dsheffie/hw-rasterizer/(commit log)

2023-11-26 broken control flow but rasterizing x dim
2023-11-27 maybe flow control works
2026-06-07 fix early termination in triangle and build on linux
    [rasterize.sv, top.cc]
2026-06-08 refactor host triangle setup into setup.cc; software depth buffer
    Split the host-side geometry math out of the RTL harness:
    - setup.{h,cc}: vertex3d, tri_setup, and setup_triangle() compute the
    edge weights and depth plane equation (dzdx/dzdy/z_start, area) that
    the rasterizer RTL iterates. No Verilator dependency.
    - top.cc: now strictly RTL interaction -- model, framebuffer, software
    depth buffer (nearest-z test), and PPM output. render_triangle() draws
    two intersecting-plane triangles to exercise the depth test. Dropped
    dead debug code (crossp/check_frag/pixel_t/w_int/n_pix).
    - Makefile: build setup.o.
    - .gitignore: ignore build artifacts.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
2026-06-08 interpolate depth in fixed-point, normalized once per triangle
    Replace the unnormalized z*area depth path with a true fixed-point
    representation, dividing by area once per triangle in setup instead of
    once per fragment in the harness.
    - rasterize.sv: depth stepper widened to a named DEPTH_INT_BITS.DEPTH_
    FRAC_BITS (25.12) format; output drops the fraction bits.
    - setup.{h,cc}: normalize dz/dx, dz/dy and Zs by 2*area into Q.12 fixed
    point (with +0.5 LSB rounding); drop the now-unused 'area' field.
    - top.cc: pixel_q is already true depth, so remove the per-fragment
    divide before the depth test.
    Bounded register width (independent of triangle/screen size) and depths
    that are directly co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
    [rasterize.sv, setup.cc, setup.h, top.cc]
2026-06-08 docs: add HTML writeup of the depth setup + stepping flow
    Document the host/hardware split: setup.cc computes edge functions and
    the depth plane (Cramer's rule, normalized once per triangle into the
    named DEPTH_*_BITS fixed-point format), and rasterize.sv steps it. Covers
    the format constants, the stepper, the end-to-end data flow, and the
    bounded-width vs rounding trade-off.
2026-06-08 flatten triangle_t struct into individual vertex registers
    r_tri only ever held the six latched input coords; replace the packed
    struct with plain logic [31:0] registers (r_v0_x .. r_v2_y) to match the
    rest of the module's style. Pure rename, no behavior change.
    [rasterize.sv]
2026-06-08 add 3D software pipeline to render OBJ models
    The rasterizer RTL only does 2D screen-space rasterization (per the CRIME
    model, the host does everything before rasterization). Add the host-side
    front-end that turns a model into the screen-space triangles setup.cc
    already consumes:
    - obj.{h,cc}: minimal Wavefront OBJ loader (v/f, fan-triangulates polys).
    - pipeline.{h,cc}: model/view/projection transform, near-plane reject,
    perspective divide, viewport mapping, screen-winding fixup (so coverage
    matches the RTL), and flat (N.L) shading. Auto-fits the model to the view.
    - top.cc: load the model (path from argv, default bigguy.obj), run the
    pipeline, rasterize each triangle; add a framebuf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
    [obj.cc, obj.h, pipeline.cc, pipeline.h, top.cc]
2026-06-08 docs: expand HTML writeup to the full OBJ-to-pixels pipeline
    Broaden the depth-focused doc into an end-to-end architecture overview:
    add the model loader (obj.cc) and the 3D software pipeline (pipeline.cc --
    transform, project, near-reject, winding fixup, flat shading), with a file
    map and a stage diagram. Keep the per-triangle setup, fixed-point format,
    RTL stepper, and software depth-buffer sections, reframed as stages of the
    larger pipeline.
2026-06-08 docs: add next-steps roadmap
    Capture the deferred first-cut items (near-plane clipping, screen-edge
    clipping, backface culling), the CRIME-style trajectory of moving the
    depth buffer into hardware, rendering features (smooth shading,
    perspective-correct attributes, textures), and repo hygiene (OBJ test
    assets, a deterministic depth regression).
2026-06-08 add backface culling (toggle with --no-cull)
    Cull triangles whose eye-space normal points away from the camera before
    rasterizing. For a closed mesh this drops ~half the triangles with no
    visible change (the depth buffer was hiding them anyway).
    Measured on bigguy.obj: 2872 -> 1437 triangles, 405k -> 207k clocks,
    116k -> 58k fragments; the lit image is identical except ~0.7% of pixels
    along silhouette/fold edges, where removing back faces flips a few
    integer-depth ties.
    On by default; --no-cull disables it for A/B comparison.
    [pipeline.cc, pipeline.h, top.cc]
2026-06-09 docs: add tile-based architecture target and CRIME UMA tradeoff
    Capture the on-chip-tile (render-to-SRAM) target that closes the framebuffer
    bandwidth wall, and contrast it with CRIME's shared-UMA bet (media interop,
    flexibility, cost vs 3D throughput). Notes the tile/TLB naming collision.
2026-06-18 add perspective-correct texture mapping (host UV + RTL steppers)
    Parse vt texcoords and carry uv + 1/w through the pipeline, set up u/w,
    t/w, 1/w as screen-space planes (same Cramer's-rule determinant as the
    depth plane), and interpolate them in the RTL with three steppers that
    mirror the existing depth stepper. top.cc feeds the host-computed plane
    gradients as fixed point, reads the stepped values back from the fragment
    queue, does the per-fragment reciprocal, recovers (u,v), and samples a
    procedural checkerboard modulated by the flat shade.
    - obj.cc/obj.h: parse and store vt per face vertex
    - pipeline.cc/pipeline.h: screen_tri carries uv + 1/w (follows winding swap)
    - setup.cc/setup.h: se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
    [obj.cc, obj.h, pipeline.cc, pipeline.h, rasterize.sv, setup.cc, setup.h, top.cc]
2026-06-18 prototype the fixed-point reciprocal in software (Stage C groundwork)
    Replace the float 1/w divide with recip_fixed(): a bit-accurate software
    model of the planned RTL reciprocal unit -- normalize via clz, 256-entry
    Q16 seed ROM, Newton y' = y*(2 - d*y). Every internal op is integer and
    maps 1:1 to hardware (clz, shift, table lookup, 2 mults/iter).
    Instrument worst-case relative error over the real 1/w values rendered:
    seed-only 0.20%, +1 Newton 0.003%, +2 Newton 0.0029% (Q16 floor).
    Confirms an 8-bit seed + 1 Newton iteration is the sweet spot.
    Image is pixel-identical to the float divide; no RTL yet, the module is
    now a mechanical transcription of this model.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
    [top.cc]
2026-06-18 add --spin N to render a rotation sequence for artifact inspection
    Parameterize project_mesh with a yaw angle (default 35 deg, so single-frame
    behavior is unchanged) and add --spin N to top.cc, which renders N frames
    over 360 deg as frame_NNN.ppm. Used to eyeball perspective-correctness and
    texture artifacts in motion (ffmpeg/convert the frames into mp4/gif).
    Also gitignore the render outputs (frame_*.ppm, *.mp4, *.gif).
    [pipeline.cc, pipeline.h, top.cc]
2026-06-18 add --sdl live viewer (spin the model in a window)
    Renders each frame through the RTL into a streaming RGB24 SDL texture, so
    texture/perspective artifacts can be inspected interactively in motion.
    Controls: Esc/Q quit, Space pause, Left/Right nudge yaw. Degrades to a
    clean error if no display is available.
    Linux now links SDL2 via pkg-config (cflags + libs), matching the Darwin
    branch that already linked it.
    [top.cc]
2026-06-18 integrate the hardware reciprocal into the rasterizer datapath
    The 1/w stepper now feeds the pipelined recip; a 4-deep side-band carries
    (addr, depth, u/w, t/w) in lockstep with the reciprocal's latency so they
    realign at the output, where a multiply + variable shift recovers u,v in
    Q16 (u = (sw*y) >> e). The output queue now carries (addr, depth, u, v);
    push fires on recip.valid_out, and DRAIN waits for the recip pipe to flush
    (busy) as well as the queue. A global clock-enable (= queue-not-full)
    freezes scan + recip + side-band together so a full queue never drops
    in-flight fragments.
    recip.sv gains en (clock-enable) and busy; still bit-exact in recip_tb.
    top.cc reads u_q/v_q directly an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
2026-06-18 move depth buffer into BRAM (HW depth test) + pipeline the attribute multiplies
    The two changes are intertwined in rasterize.sv (the multiply pipeline feeds
    the depth-test stage), so they land together.
    Hardware depth buffer:
    - Z BRAM (16-bit x SCREEN_W*SCREEN_H) with a 1-stage depth test (Z1) that
    absorbs the BRAM read latency: register the fragment + its depth read, then
    compare (nearest wins) and on pass write depth + push (addr,u,v). Only
    depth-passing fragments enter the queue, so depth drops out of the
    interface (pixel_q removed).
    - clear FSM: a `clear` pulse walks the buffer writing the far value; `clearing`
    high meanwhile. top.cc drops its software z-buffer and clears th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
2026-06-18 move color framebuffer + texturing/shading into BRAM (on-chip backend)
    The whole fragment backend now lives in the PL. At the depth-test stage,
    depth-passing fragments are shaded and written straight into an on-chip color
    framebuffer; the host just feeds triangles and scans the framebuffer out.
    rasterize.sv:
    - color FB BRAM (24-bit) + host readout port (fb_raddr/fb_rdata, registered).
    - checkerboard texture-gen in RTL: tile parity = u_q16[13]^v_q16[13] (8 tiles).
    - shade modulate in RTL: floor(texel*shade/255) exact via ((x+1)*257)>>16.
    - color written alongside the depth write; the clear FSM now clears both
    color and depth in one sweep.
    - output queue removed entirely (the FB write is t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
2026-06-18 add Gouraud shading (per-vertex lighting, affine color steppers)
    Parse vn for per-vertex normals; light each vertex by its own eye-space
    normal (two-sided N.L, falls back to the face normal if a vertex has none)
    and carry per-vertex RGB through to the rasterizer. Three affine color
    steppers (no reciprocal -- color interpolates linearly in screen space, the
    classic GL/Quake behavior) interpolate R,G,B; the per-pixel color is clamped
    to [0,255] and carried down the side-band -> MUL -> SHIFT -> Z1 alongside the
    fragment, then modulates the checkerboard texel (GL_MODULATE) in place of the
    old flat per-triangle shade.
    - obj.cc/obj.h: parse and store per-vertex normals
    - pipeline.cc/pipeline.h: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
2026-06-18 add real texture memory (sampled texture BRAM, REPEAT wrap)
    Replace the procedural checkerboard with a sampled texture in BRAM.
    - texture BRAM (128x128 24-bit RGB), power-of-two so REPEAT wrap is just a
    low-bit mask (handles negative/tiling uv via arithmetic shift + mask).
    - texel address = uv >> (16-TEX_LW), low TEX_LW bits per axis.
    - texture read issued at the Z1 input (SHIFT-stage uv) so the texel lands at
    Z1 aligned with the fragment -- same trick as the depth read, no new stage.
    - host write port (tex_we/tex_waddr/tex_wdata) to load the texture.
    - modulate is now texel * Gouraud color per channel (full GL_MODULATE).
    top.cc: load_test_texture uploads a u->red,v->gree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
    [rasterize.sv, top.cc]
2026-06-19 add bilinear texture filtering (4-bank quad fetch) + build-time resolution knob
    Bilinear filtering:
    - split the texture into 4 BRAM banks by (x&1,y&1) so any 2x2 quad is one
    texel per bank -> all four read in parallel, conflict-free, in one cycle
    (no added latency; reads issued at the Z1 input like the depth read).
    - texel coord with a half-texel offset -> base texel + Q9 fractions + parities;
    REPEAT via low-bit mask (power-of-two, so no out-of-bounds possible).
    - per-bank address gen picks each bank's column/row by parity; host loads
    linearly and the RTL routes each texel to bank {tv[0],tu[0]} at (tv>>1,tu>>1).
    - un-swizzle crossbar maps the 4 banks to T00/T10/T01/T11 by (px,py), th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
    [rasterize.sv, top.cc]
2026-06-19 add mipmapping (per-triangle LOD, bilinear on the selected level)
    Fixes the minification "popping"/shimmer: instead of undersampling the full
    resolution texture on far/oblique surfaces, sample a pre-averaged mip level.
    top.cc:
    - build the mip chain by box-filter downsampling (8 levels, 128..1).
    - per-triangle LOD = 0.5*log2(texel_area / screen_area), clamped [0,7] -- the
    area-ratio form of the uv Jacobian, computed on the A53.
    - upload to the banked stacked storage (texel -> bank {y&1,x&1}, addr
    {level, y>>1, x>>1}).
    - the 4 bilinear banks now hold the whole mip chain, a uniform (TEX_W/2)^2 slot
    per level, so a bank address is just {level, row>>1, col>>1} (no var stride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
    [rasterize.sv, top.cc]
2026-06-19 docs: add datapath block diagram
    Curated Graphviz block diagram of rasterize.sv + recip.sv (host setup vs PL
    iteration, the stepper/recip/texture/depth stages, on-chip memories, and the
    side-band), embedded on the home and hardware-pipeline pages. The .dot source
    lives alongside so it can track the RTL (regenerate with dot -Tsvg).
2026-06-19 add per-pixel level of detail (analytic uv Jacobian)
    Replaces the per-triangle LOD, which made the mip level constant across each
    face -- on large faces at varying grazing angles (e.g. a torus) adjacent faces
    picked different levels and the texture detail shattered at every seam.
    Per fragment, compute the uv Jacobian analytically (no neighbor sampling):
    du/dx = w*(d(u/w)/dx - u*d(1/w)/dx), etc.
    using the constant per-triangle gradients (dswdx, diwdx, ...) and the per-pixel
    u, v, and w. w is carried down as w*16 = y>>e (free from the reciprocal's
    mantissa/exponent). Take max|.| of the four partials, multiply by w, and clz
    the footprint: LOD = msb + TEX_LW - 16, clamped [0,7]. This per-p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
    [rasterize.sv, top.cc]
2026-06-19 use a broadband (value-noise) default texture; --grid keeps the debug grid
    The UV gradient+grid texture is a worst case for aliasing (1-texel high-contrast
    lines zig-zag under per-pixel sampling). Default to a broadband tiling
    value-noise "stone" texture (2 smoothstep octaves, seamless at the edge), which
    mipmaps and filters cleanly -- the texture-line jaggies are gone, leaving only
    the geometry silhouette (which needs real AA). --grid restores the gradient+grid
    for UV/perspective debugging.
    [top.cc]
2026-06-19 rtl: drop +: part-selects; add alpha blending
    - replace the variable-base +: part-selects (per-pixel mip fraction) with an
    explicit shift + fixed range, per the Verilog conventions. Verified no-op.
    - alpha blending: per-triangle blend_mode (0 opaque / 1 src-over / 2 additive)
    + tri_alpha. The color framebuffer becomes a read-modify-write (dst read
    issued at the Z1 input like the depth read, blended via blend_c, written
    back). Non-opaque modes test depth but suppress the depth write (standard
    transparency). blend_c reuses the exact /255 for src-over.
    [rasterize.sv]
2026-06-19 add hw_rast engine abstraction (Verilated backend); --blend demo
    Introduce hw_rast.h: an abstraction over the rasterizer engine so the graphics
    stack is built on a stable API, not the transport. hw_tri is one fully-set-up
    triangle (fields mirror the RTL ports); the opaque hw_rast handle exposes
    open/close/clear/tex_write/draw_tri/fb_read.
    hw_rast_verilated.cc implements it by driving the Vrasterize model (the tick/
    poke/readout logic moved out of top.cc). A future hw_rast_fpga.c implements
    the same header over AXI; switching backends is a link-time choice.
    top.cc now does only the per-triangle setup math (CPU, shared by all backends),
    fills an hw_tri, and calls hw_draw_tri -- no Verilato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
2026-06-19 split top.cc: extract reusable engine front-end (gfx) from the OBJ demo
    Pull the host-side glue that any engine driver needs out of top.cc into gfx.cc
    (on top of hw_rast.h), so it can be shared with the coming IRIS GL / libgl
    backend instead of being duplicated:
    - submit_triangle(): the per-triangle setup math (edge functions, depth/
    attribute/color planes) -> hw_tri -> hw_draw_tri.
    - load_texture(): build the mip chain from a base image + banked upload.
    Plain-C interface (no pipeline.h/setup.h leakage) so a C backend can call it.
    top.cc -> obj_demo.cc, now purely the OBJ viewer (texture content generation,
    projection, frame loop, PPM, SDL, args); render_triangle is a thin screen_tri
    -> s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
    [gfx.cc, gfx.h, obj_demo.cc]
2026-06-19 add IRIS GL rasterizer backend + isolation test
    Implement sgi-demos libgl's rasterizer.h (hw_rasterizer.cc) by driving our
    hardware engine via gfx/hw_rast -- a drop-in for reference_rasterizer.c, so
    gl.c can rasterize SGI/IRIS GL demos on the (Verilated) PL. Maps screen
    vertices to the engine (/32 subpixel, GL y-up -> top-down, z>>16 to 16-bit,
    winding fix for our positive-area coverage), expands lines/points to quads, and
    scans the FB out to a BGRA front buffer. Untextured via a bound white texture
    (texel*color modulate passes Gouraud color through). First cut stubs: clear
    color (always black), zbuffer-disable, text glyphs, stipple.
    rasterize.sv: SCREEN_WIDTH/SCREEN_HEIGHT knobs (defaul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
    [hw_rasterizer.cc, rast_test.cc, rasterize.sv]
2026-06-19 run the SGI "ideas" IRIS GL demo on our engine
    Add a `make ideas` / `ideas_hw` target that builds the sgi-demos "ideas" demo
    the repo's own way (its shim / K&R-C / GLES handling, via clang) and re-links it
    against OUR rasterizer: by placing hw_rasterizer + the engine objects ahead of
    libgl.a, the linker resolves rasterizer_* from us and never pulls
    reference_rasterizer.o -- so we reuse gl.c/libdemo unmodified. Builds the engine
    at the SGI 800x480 display size. The demo renders recognizably end to end (lit
    floor, spotlight, card, SGI logo, the animated orb matches the reference).
    hw_rasterizer.cc: headless capture/exit hooks for verifying demos without a
    display -- GEN_FRAME_PPM_FILES=1 du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
    [hw_rasterizer.cc, setup.cc]
2026-06-19 docs: add Sub-pixel coordinates page
    New page explaining sub-pixel rasterization: the integer-snapping problem
    (coarse staircase + crawl under motion), keeping the 1/32 fixed-point fraction,
    evaluating coverage at pixel centers in full precision, why the forward-
    differenced inner loop is unchanged (richer setup values only), the watertight-
    shared-edge and depth/attribute-accuracy payoffs, and that it's not antialiasing.
    Includes a Status section: our engine currently truncates to integer vertices
    (hw_rasterizer.cc sv.x/32), the source of the ragged edges in the IRIS GL demos,
    with the concrete fix.
    Insert it after Edge functions (nav_order 3); bump the following pages to 4..10,
    update the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
2026-06-19 implement sub-pixel coordinates across the engine
    Carry the 1/32 sub-pixel vertex fraction through coverage and plane setup instead
    of truncating to integer pixels, so triangle edges land where the geometry
    actually is (smoother silhouettes, no whole-pixel snapping/crawl) and adjacent
    edges stay watertight.
    - setup.cc: edge functions evaluated at each pixel's CENTER in ×32^2 units; the
    depth/attribute planes computed in floating pixel coordinates so the gradients
    come out per whole pixel, also sampled at the center.
    - rasterize.sv: vertices are sub-pixel (×32); the bounding box is the whole-pixel
    floor (min/max >> 5) and the per-pixel edge-function step is scaled << 5. The
    inner s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
    [hw_rasterizer.cc, obj_demo.cc, rast_test.cc, rasterize.sv, setup.cc, setup.h]
2026-06-19 add depth-test enable (painter's) + widen depth to 24-bit
    The SGI "ideas" demo draws the floor/card/logo in zbuffer(FALSE) sections: the
    logo is a decal painted onto the coplanar card, relying on draw order, not depth.
    Our engine always depth-tested, so the coplanar logo z-fought the card and
    rendered as broken wireframe.
    - rasterize.sv: per-triangle z_enable (latched at go like blend_mode); the depth
    test becomes ~z_enable | (depth < zold), so a disabled z-buffer makes every
    covered fragment pass (painter's). Depth is still written, matching the
    reference rasterizer. Also Z_W 16 -> 24: a precision win for depth-TESTED
    content (OBJ demo, future GLQuake); fits DEPTH_INT_BITS=25 and t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
    [gfx.cc, gfx.h, hw_rast.h, hw_rast_verilated.cc, hw_rasterizer.cc, obj_demo.cc, rasterize.sv]
2026-06-20 build any sgi-demos demo on the engine + vendor sgi-demos as a submodule
    The ideas_hw target was hardcoded to one demo; generalize it to a `%_hw`
    pattern rule so any sgi-demos/demos/<name> builds against our rasterizer with
    the same recipe (build it the repo's way, then re-link with hw_rasterizer ahead
    of libgl.a). Verified: ideas, logo, gltest, jello, bounce, newave all build and
    render; insect builds but is minutes/frame; sunflower needs CLI args.
    - Makefile: ideas_hw -> generic %_hw pattern rule; `make ideas` kept as alias.
    - sgi-demos: adopt the existing clone as a git submodule pinned at 11b84e5
    (.gitmodules + gitlink), so the demo source is tracked, not just sitting
    untracked in t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
2026-06-20 docs: add "Running the SGI demos" gallery page
    A new page showing real IRIS GL demos rendered on the engine, with a framebuffer
    dump straight off the RTL for each one and notes on what it exercises:
    - gltest: the minimal flat-shaded "hello triangle" sanity check.
    - ideas: draws with zbuffer(FALSE) (painter's algorithm, coplanar decal) --
    the demo that drove per-triangle z_enable.
    - logo / jello / bounce: z-buffered Gouraud 3D; jello also shows the line path
    (wireframe walls) and a projected drop shadow; bounce uses vertex colors as
    colored lights.
    - newave: pure wireframe (lines -> 2-triangle quads).
    Also documents the build/run path (make <demo>_hw, headless PPM capture), the
    linker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
2026-06-20 TinyGL backend: run a real GL pipeline (GLGears) on the engine
    First step toward GLQuake-on-the-engine: vendor TinyGL (an OpenGL-1.1-subset
    software GL) as a submodule and replace ONLY its software rasterizer with our
    hardware engine. TinyGL keeps doing transform / lighting / clipping (including
    near-plane) and hands us final screen-space vertices; we rasterize them on the
    (Verilated) engine. This is the authentic Voodoo/miniGL split (T&L on the CPU,
    rasterization on the card) and the SW plumbing transfers to the ARM/PL later.
    - tinygl: C-Chads TinyGL as a submodule.
    - tgl_engine.cc: our implementation of TinyGL's low-level ZB_* rasterizer
    (ZB_fillTriangle*/ZB_line/ZB_plot) routing ZBuffe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
    [tgl_engine.cc, tgl_gears.cc]
2026-06-20 tgl_gears: add live SDL window mode (--sdl)
    Render the TinyGL gears through the engine into an on-screen SDL framebuffer,
    like obj_demo / irisgl_test: --sdl opens a window (Esc/Q quit, Space pause) and
    presents each engine frame via an RGB24 streaming texture. Headless PPM dump
    (--frames N) is unchanged.
    - tgl_gears.cc: SDL include + run_sdl() loop + --sdl flag.
    - Makefile: link sdl2-config --libs into tgl_gears.
2026-06-20 docs: miniGL design doc + Real OpenGL via TinyGL page
    - minigl-design.md: scopes the whole GL-on-the-engine stack (the seam, TinyGL
    rasterizer-swap, GL surface coverage, the no-GLU decision, vid layer, GLQuake
    object set, texturing/blending plan, FPGA transfer, open decisions, phasing).
    - opengl-via-tinygl.md: the GLGears milestone page with a framebuffer screenshot,
    linked from index. (design doc references it.)
2026-06-21 docs: GLQuake on the engine — status, frames, and learnings
    New page glquake.html: the GLQuake milestone (boots, loads maps, renders the
    world + viewmodel + entity models, depth-tested, untextured) with two captured
    frames, the TinyGL+engine wiring, build/run + the HW_STATS triangle heartbeat,
    and a Learnings section on the three hard bugs (32-bit string_t offset / BSS
    heap, POLYGON_MAX_VERTEX overflow into global state, texture impedance mismatch)
    plus the meta-lesson that the per-frame triangle count was the key diagnostic.
    Linked from index; opengl-via-tinygl forward-links to it.
2026-06-21 GLQuake: perspective-correct textures on the engine
    tgl_engine.cc now uploads bound textures to the engine and feeds
    perspective u/v + 1/w, taking GLQuake from flat-white to fully textured.
    - Texture residency: the engine has one texture memory, so swap it only on
    texture change (Quake draws by texture chains -> ~24 uploads/frame).
    Box-downsample TinyGL's 256^2 PIXEL pixmap to the engine's 128^2 RGB base;
    load_texture builds the mip chain. Untextured fills bind a white texture
    so GL_MODULATE (texel*color) reduces to pure vertex color.
    - Perspective without a projection matrix: TinyGL's screen depth zp.z
    (near=large) is affine in 1/w, so it *is* the perspective denominator.
    Feed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
    [tgl_engine.cc]
2026-06-21 GLQuake: lightmaps via a modulate blend pass
    GLQuake lights the world in two passes (gl_texsort): base texture opaque,
    then the same surfaces re-drawn sampling the lightmap and multiplied into the
    framebuffer. With one texture unit, the engine does the same two passes.
    - rasterize.sv: add blend mode 3 = modulate (dst*src). Use a <= depth test
    for blended passes so the coplanar lightmap overlay (identical geometry to
    the base pass) passes the equal-depth test; opaque keeps strict < to avoid
    z-fighting. Only opaque writes depth, matching GLQuake's glDepthMask(0).
    (The strict < was silently killing the whole coplanar pass before.)
    - tgl_engine.cc: blend_mode_from() maps TinyGL's glB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
    [rasterize.sv, tgl_engine.cc]
2026-06-22 GLQuake: dynamic lights (lightmap glTexSubImage2D updates)
    Honor GLQuake's per-frame lightmap updates so torches flicker and muzzle
    flashes / explosions light the scene:
    - Bumps tinygl (real glTexSubImage2D) and hwrast-sdlquake (lm_updates heartbeat)
    submodules; removes the old no-op glTexSubImage2D stub from tgl_quake_compat.c.
    - tgl_engine.cc: defines the tgl_lm_updates counter.
    - No cache work needed: the base-texture pass evicts every lightmap from the
    engine's single texture memory each frame, so an updated atlas re-uploads
    automatically on the next lightmap pass.
    Verified on demo1 -- lm_updates spikes 1-3 during combat and the scene brightens
    where the action is (same geometry/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
2026-06-22 tgl_engine: fix lightmap black-triangle artifacts (normalize invw by zmin)
    The perspective denominator invw = zp.z was normalized per-triangle by zmax,
    which drives the far vertex's invw toward 0. Base-texture UVs are large (Quake
    tiles them) so they survived, but a surface's lightmap UVs are tiny (its luxels
    are a small patch of the 128^2 atlas) -- uv*invw then underflowed the Q12
    fixed-point to 0, sampling a garbage/black luxel per triangle. Result: hard
    black triangular wedges on distant/grazing lightmapped surfaces.
    Normalize by zmin instead so the smallest invw is 1. The perspective divide is
    scale-invariant, so the result matches TinyGL exactly -- only the fixed-point
    conditioning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
    [tgl_engine.cc]
2026-07-03 tgl_engine: fix opaque translucent blends + floor perspective warping
    Two GLQuake rendering fixes, both in the invw/blend seam.
    Alpha path: translucent and additive draws were rendered opaque -> full-screen
    colored flashes (screen polyblend) and dark blobs (flashblend dlight coronas).
    The untextured GL_BLEND fill variants (ZB_fillTriangleFlat/Smooth, reached only
    when GL_BLEND is on) hardcoded blend mode 0 = opaque, and no source alpha was
    carried. Now they map the active glBlendFunc via blend_mode_from() and thread the
    per-vertex alpha (new ZBufferPoint.a, from the TinyGL bump) into submit_triangle's
    tri_alpha. The RTL already supported it (rasterize.sv blend_c: mode 1 src-over =
    mul255(sr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
    [tgl_engine.cc]
2026-10-18 rasterize: pipeline the post-SHIFT datapath (feed-forward, no stalls)
    The level-of-detail block and the texel-read -> bilinear -> modulate -> blend
    -> framebuffer-write path were each a single cycle (20.1 ns, 68 logic levels
    on a KU5P). Split them into feed-forward stages on the existing always-on
    pipe enable:
    L1 u,v x (dw/dx, dw/dy) products L2 Jacobian |A| max
    L3 footprint multiply, L3B (DSP regs) L4 LOD priority encode
    A texel address / fractions Z1 texture + depth + dst reads
    Z2 read data registered B1 bilinear x-lerps, depth test
    B2 bilinear y-lerp C GL_MODULATE
    D blend; color + depth writes
    The arithmetic is unchan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
2026-10-18 rasterize: pack the mip chain; 18-bit depth buffer (Z_BITS)
    Texture: each bank stacked every mip level in a uniform 64x64 slot (32768
    entries for 5462 texels). Pack the levels instead -- level L holds
    (64>>L)^2 texels per bank (1 for the last two) at tex_base(L) -- computed
    in the A stage; gfx.cc load_texture uses the same mapping.
    Depth: Z_BITS (default 18 on this branch) keeps the top Z_BITS of the
    24-bit depth; 18 fills a BRAM's 18-bit port exactly. Z_BITS=24 is the
    previous behaviour. The OBJ demo now spreads depth over the full 24-bit
    range (TinyGL already does), so 18 bits keep real precision.
    Verified: Z_BITS=24 is bit-identical to the original RTL in the dual-model
    random test (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
2026-10-19 rasterize: double-buffered colour buffer; 16-bit RGB565 storage (FB_BITS)
    Two colour RAMs with a front/back select (r_front) and a swap input: draws,
    clears and blend reads go to the back buffer, fb_raddr scans out the front.
    FB_BITS (default 16) stores RGB565 with bit replication on read; FB_BITS=24
    keeps full RGB888. hw_swap() added to the API; hw_fb_read swaps first.
    Verified: dual-model equivalence at Z_BITS=24 FB_BITS=24 vs the original
    (seeds 1,2,3,11,12, alternating back buffers). FB 16 vs 24 at equal depth:
    max 7/channel (RGB565 rounding) on gears.
    Claude-Session: https://claude.ai/code/session_016xfvfmXV8dUTCShBt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
2026-10-19 Ultra96 standalone: AXI-Lite wrapper, /dev/mem driver, Vivado build
    rast_axi.v: AXI4-Lite slave around rasterize (320x200) -- triangle register
    file held stable through the render, go/clear/swap pulses, STATUS busy,
    auto-incrementing TEX_DATA and FB_DATA ports. Plain Verilog so it can be a
    block-design module reference.
    hw_rast_axi.cc: hw_rast.h backend over the register block -- /dev/mem on the
    A53, or (HW_RAST_AXI_SIM) a Verilated rast_axi. make obj_demo_axi (board),
    make obj_demo_axisim (sim). obj_demo: SCREEN_WIDTH/HEIGHT, NO_SDL.
    fpga/: Vivado 2025.1 build -- henry's PS8 configuration, rast_axi_0 at
    0xA0050000, BD named rast96 so the bitstream does not collide with henry's.
    Verifi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
2026-10-19 HW_RAST_TIMING: per-stage frame and per-operation driver timing
    Compiled out by default. obj_demo prints texture/obj load, clear, project_mesh,
    draw loop, hw_fb_read and PPM write per frame; hw_rast_axi prints clear, texture
    upload, wait-for-previous-triangle, register writes, drain+swap and scan-out at
    hw_close. Ultra96 (rast96 f146b84 bit, 320x200, ~1226 tris/frame): scan-out
    13.5 ms (64000 x 211 ns AXI-Lite reads), draw loop 3.5 ms (~2.9 us/tri: 1.25
    register writes, ~1.2 setup math, 0.46 wait), project_mesh 2.8 ms, clear 0.64 ms.
    Claude-Session: https://claude.ai/code/session_016xfvfmXV8dUTCShBtrkiAu
